kdawgwilk/gelway/README.md

This project was exported from Google Code and all credit goes to Steven Witzand

# GELway - A self-balancing robot #

Email: s.witzand@internode.on.net

---

[Introduction](#Introduction.md) <br>
<a href='#GELway_Videos.md'>GELway Videos</a> <br>
<a href='#Source_Code_and_Documentation.md'>Source Code and Documentation</a>
<hr />
<h2>Introduction</h2>

GELway is self-balancing robot built with LEGO and programmed with leJOS. It has been designed with a scalable behavioural and communication systems that allows for the GELway to have added functionality added to it, allowing it to perform more tasks, and work in cooperation with other robots.<br>
<br>
With the software developed over the year at UNSW@ADFA it should be easy for programmers to take this existing code and add there own functionality, building from what has already been developed. <br>

<a href='#GELway_-_A_self-balancing_robot.md'>Back to top</a>
<hr />
<h2>Source Code and Documentation</h2>
The source code as well the documentation has been included in the downloads section of this project. It includes a detailed building instructions for the robot as well as Bluetooth application for a mobile phone and PC to link to the NXT.<br>
<br>
<a href='http://code.google.com/p/gelway/downloads/list'>Downloads Section</a> <br>

<a href='#GELway_-_A_self-balancing_robot.md'>Back to top</a>
<hr />
<h2>GELway Videos</h2>

<table><thead><th>Description</th><th>Video</th></thead><tbody>
<tr><td>Driving with mobile phone, ramp testing</td><td></td></tr>
<tr><td>Using EOPD sensor to reset balance</td><td></td></tr>
<tr><td>Video showing the robustness of controller.</td><td></td></tr>
<tr><td>Weight carrying</td><td></td></tr>
<tr><td>GELway Montage - Everything (with an added steep ramp test)</td><td>|| <br></td></tr></tbody></table>

<a href='#GELway_-_A_self-balancing_robot.md'>Back to top</a>
<hr />
Developed by Steven Witzand <br>
2nd November 2009 at UNSW@ADFA University in Canberra
