kdawgwilk/gelway/GELwayBuildingInstructions.pdf

## GELway Building Instructions

## Modified version of the NXTway-GS building instructions

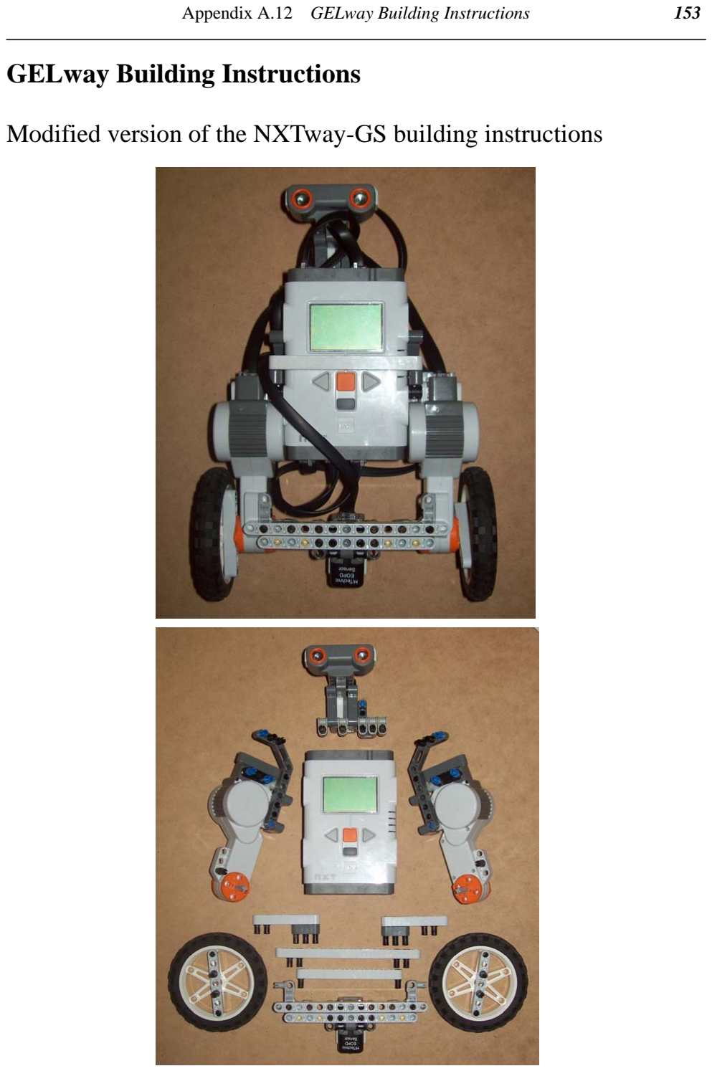
[picture p1: page 1]

Appendix A.12 GELway Building Instructions | 153

## Step 1—Building the Motor Connection

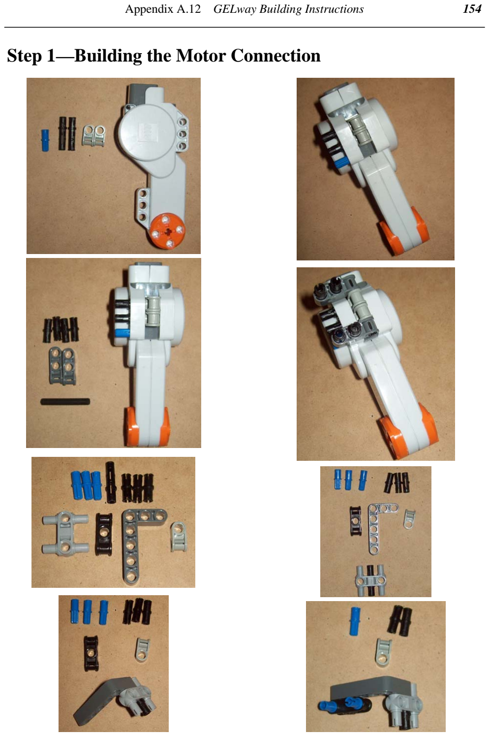
[picture p2: page 2]
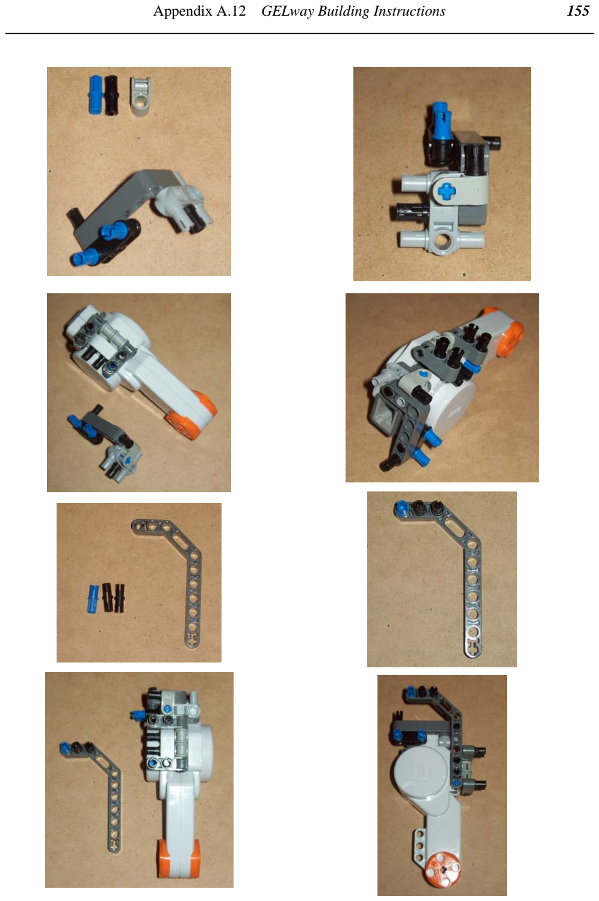
[picture p3: page 3]
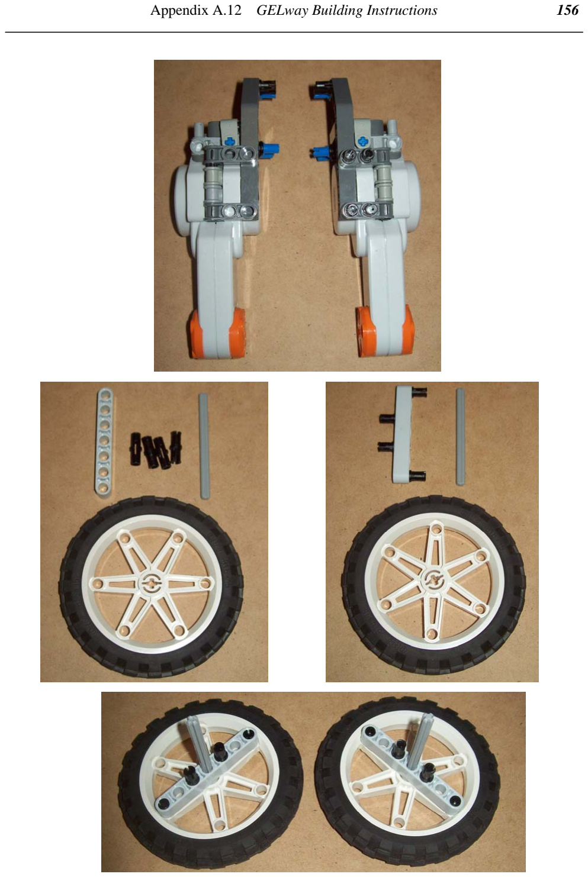
[picture p4: page 4]

## Step 3—Building the Upright Detector Frame

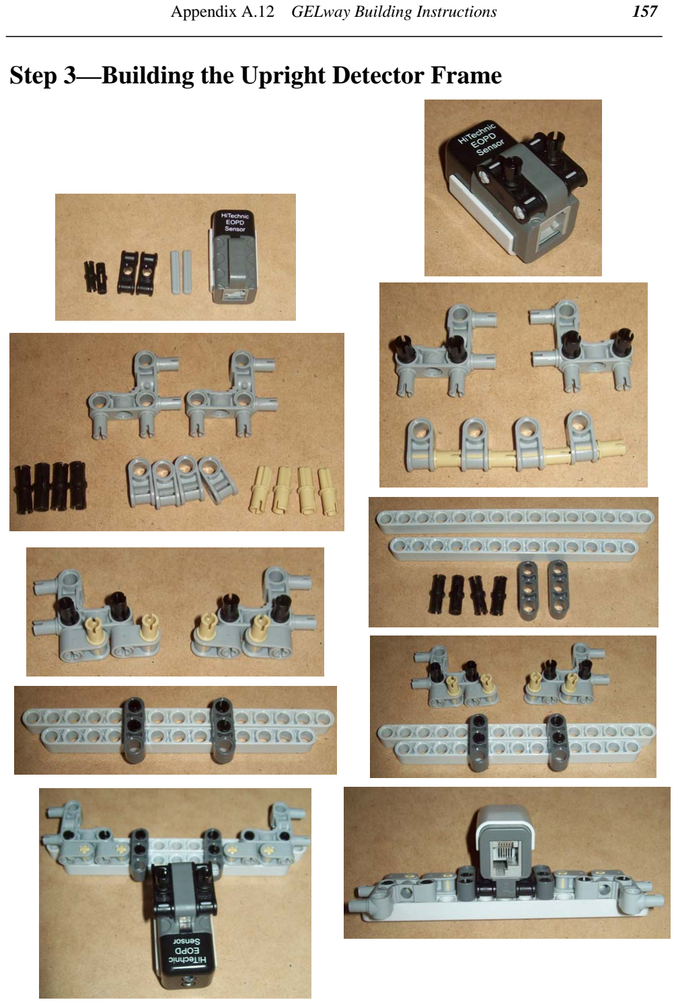
[picture p5: page 5]

## Step 3—Connecting the Motors

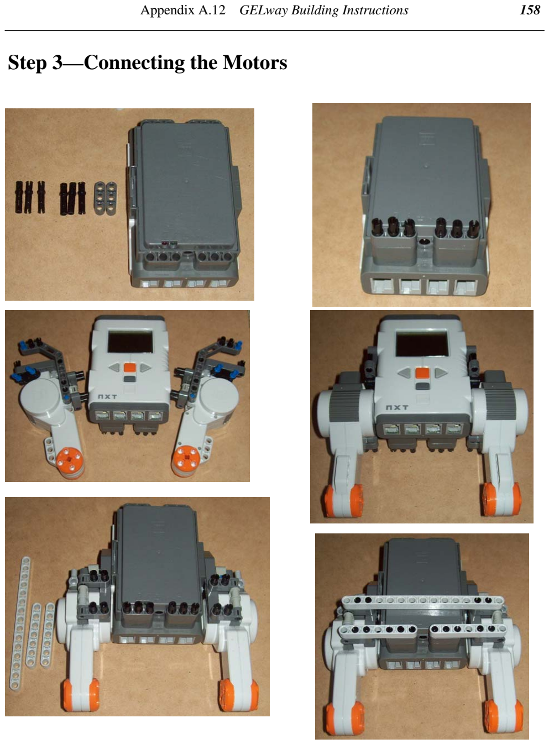
[picture p6: page 6]

## Leading Robot—Head Connection

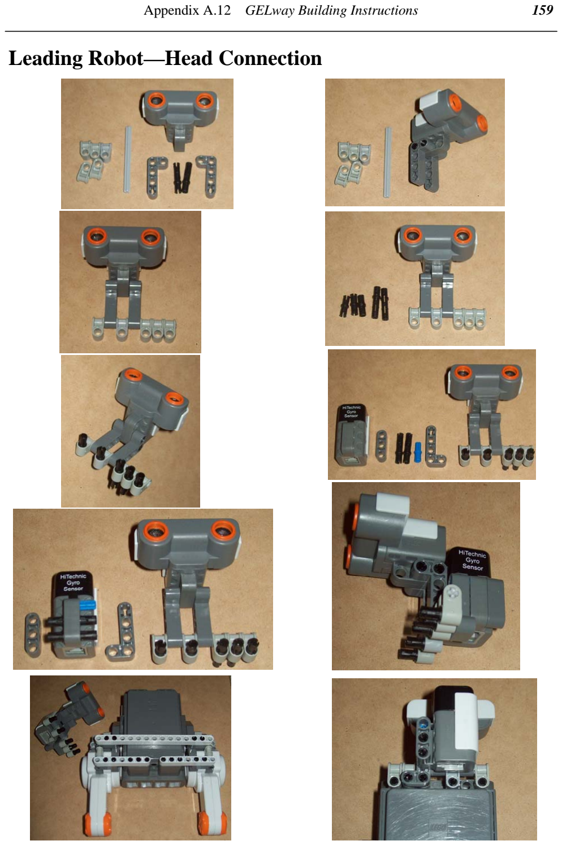
[picture p7: page 7]

## Leading Robot—Complete with Port Connections

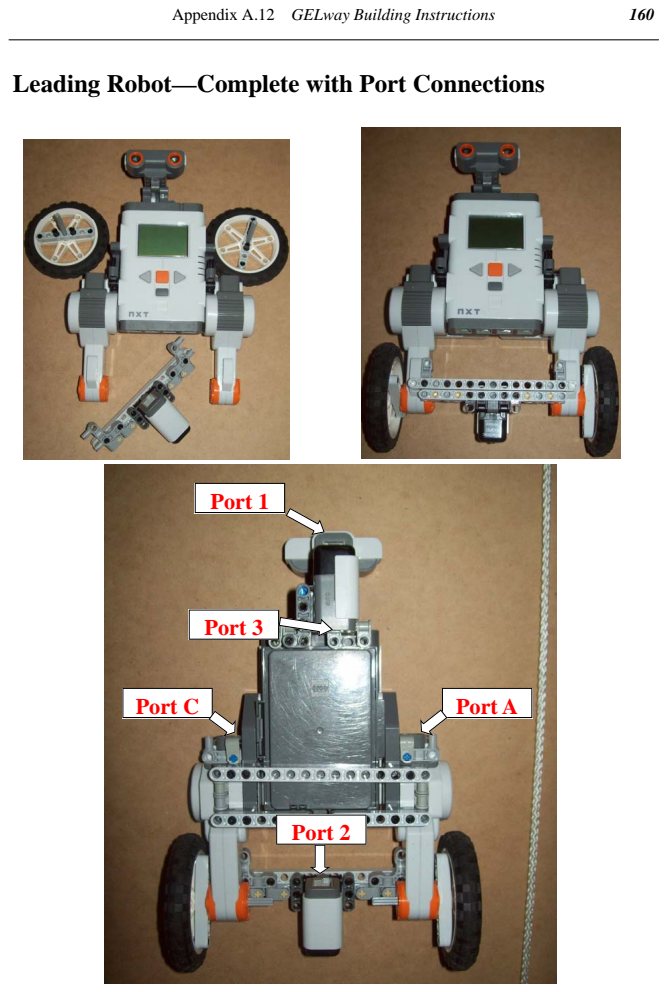
[picture p8: page 8]
Port 1; Port 3; Port C; Port A; Port 2

## Follower Robot—Head Connection

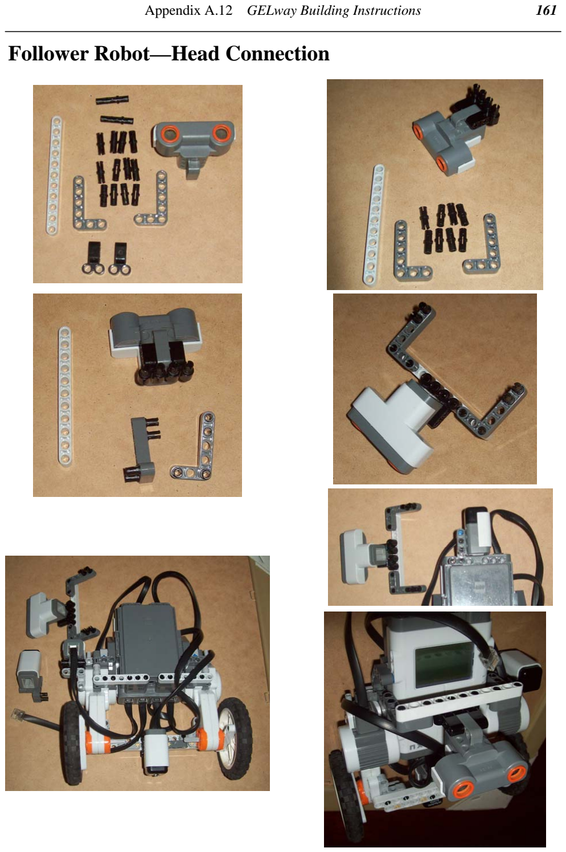
[picture p9: page 9]

### Port 3

## Follower Robot—Complete with Port Connections

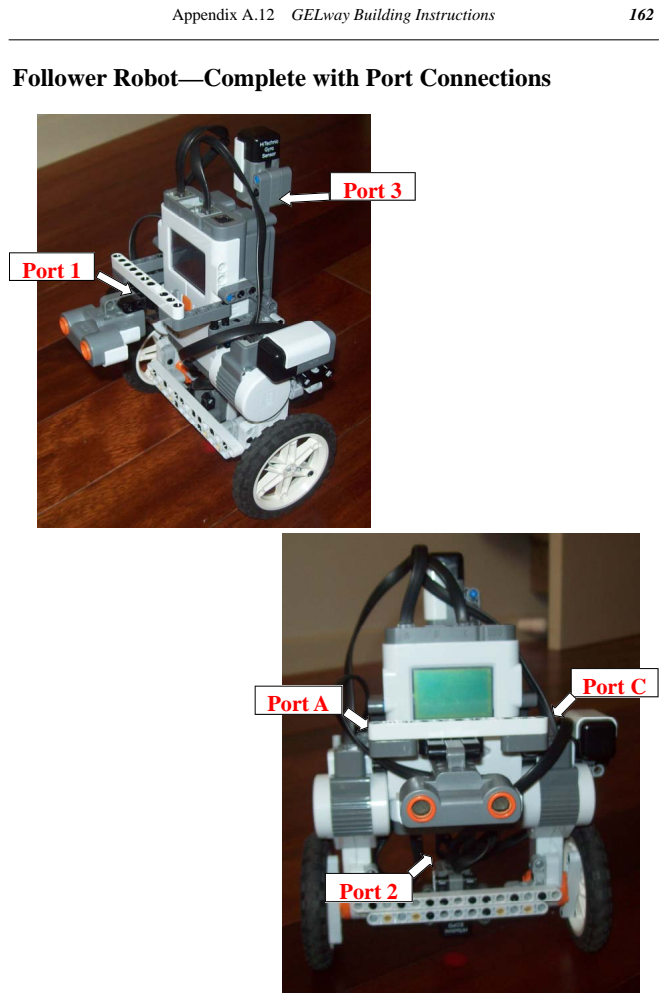
[picture p10: page 10]
Port 1; Port C; Port A; Port 2

## Weight Carrying Attachment—Sturdy Arms

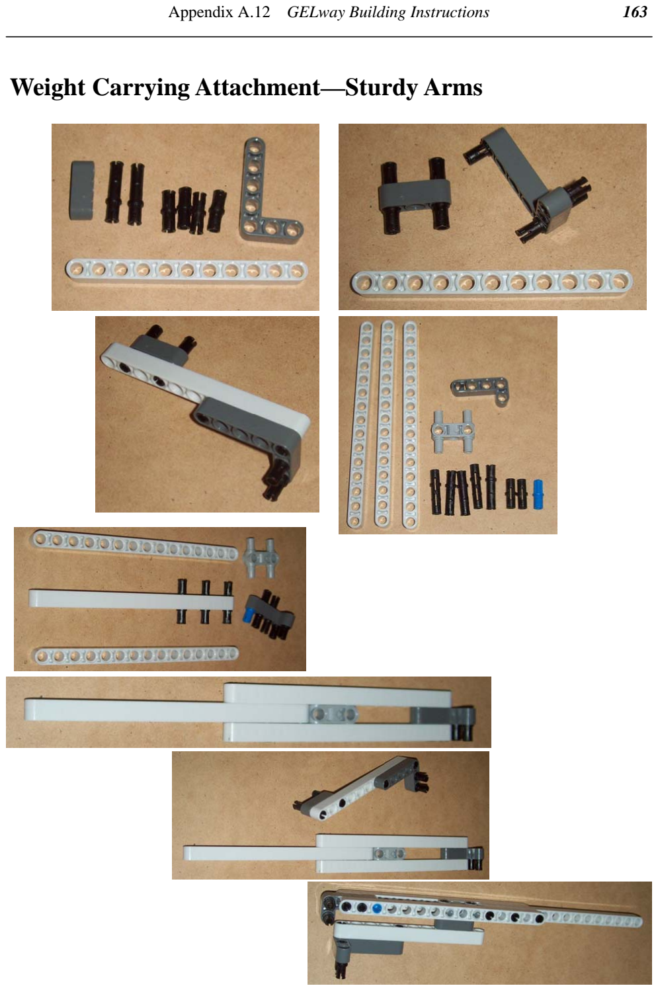
[picture p11: page 11]
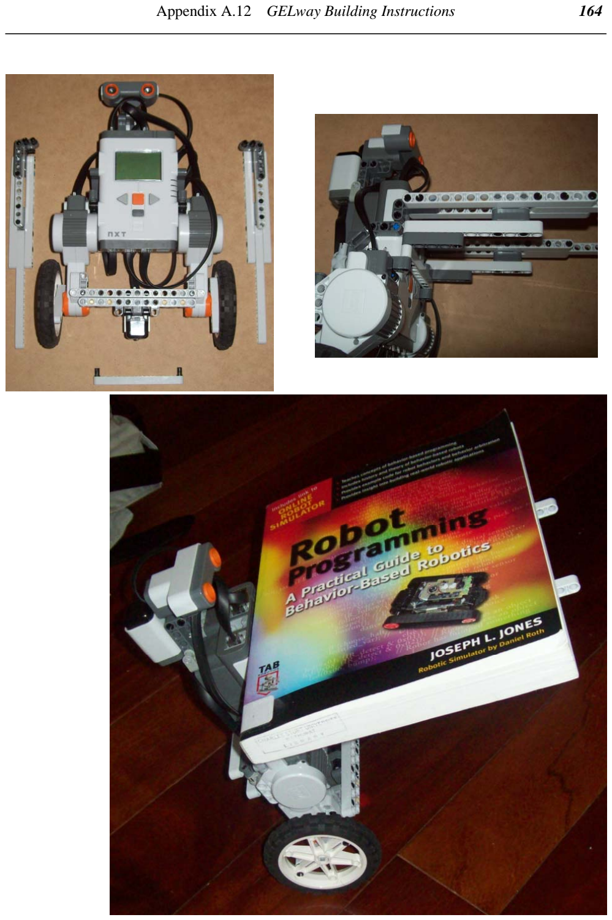
[picture p12: page 12]

## Additional Sensor Attachments

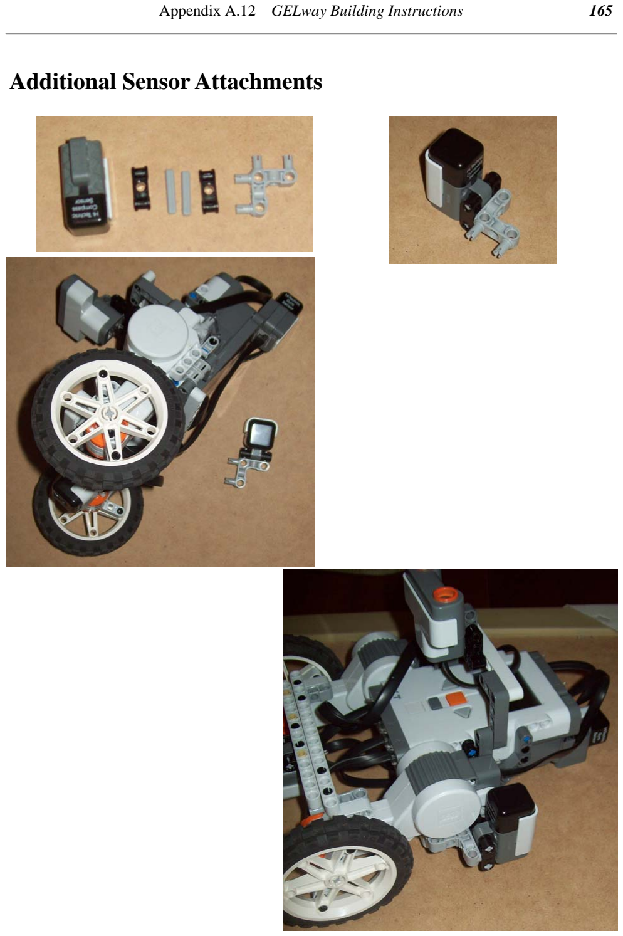
[picture p13: page 13]
